Se64s/eurorack-clock-divider/README.md

# eurorack-clock-divider

Clock divider based on [Divide &amp; Conquer](https://www.nonlinearcircuits.com/modules/p/divide-and-conquer) from NONLINEARCIRCUITS.
