Se64s/eurorack-clock-divider/pcb/clock-divider-pcb.kicad_pcb

## KiCad design pcb/clock-divider-pcb.kicad_pcb (2025-10-06)

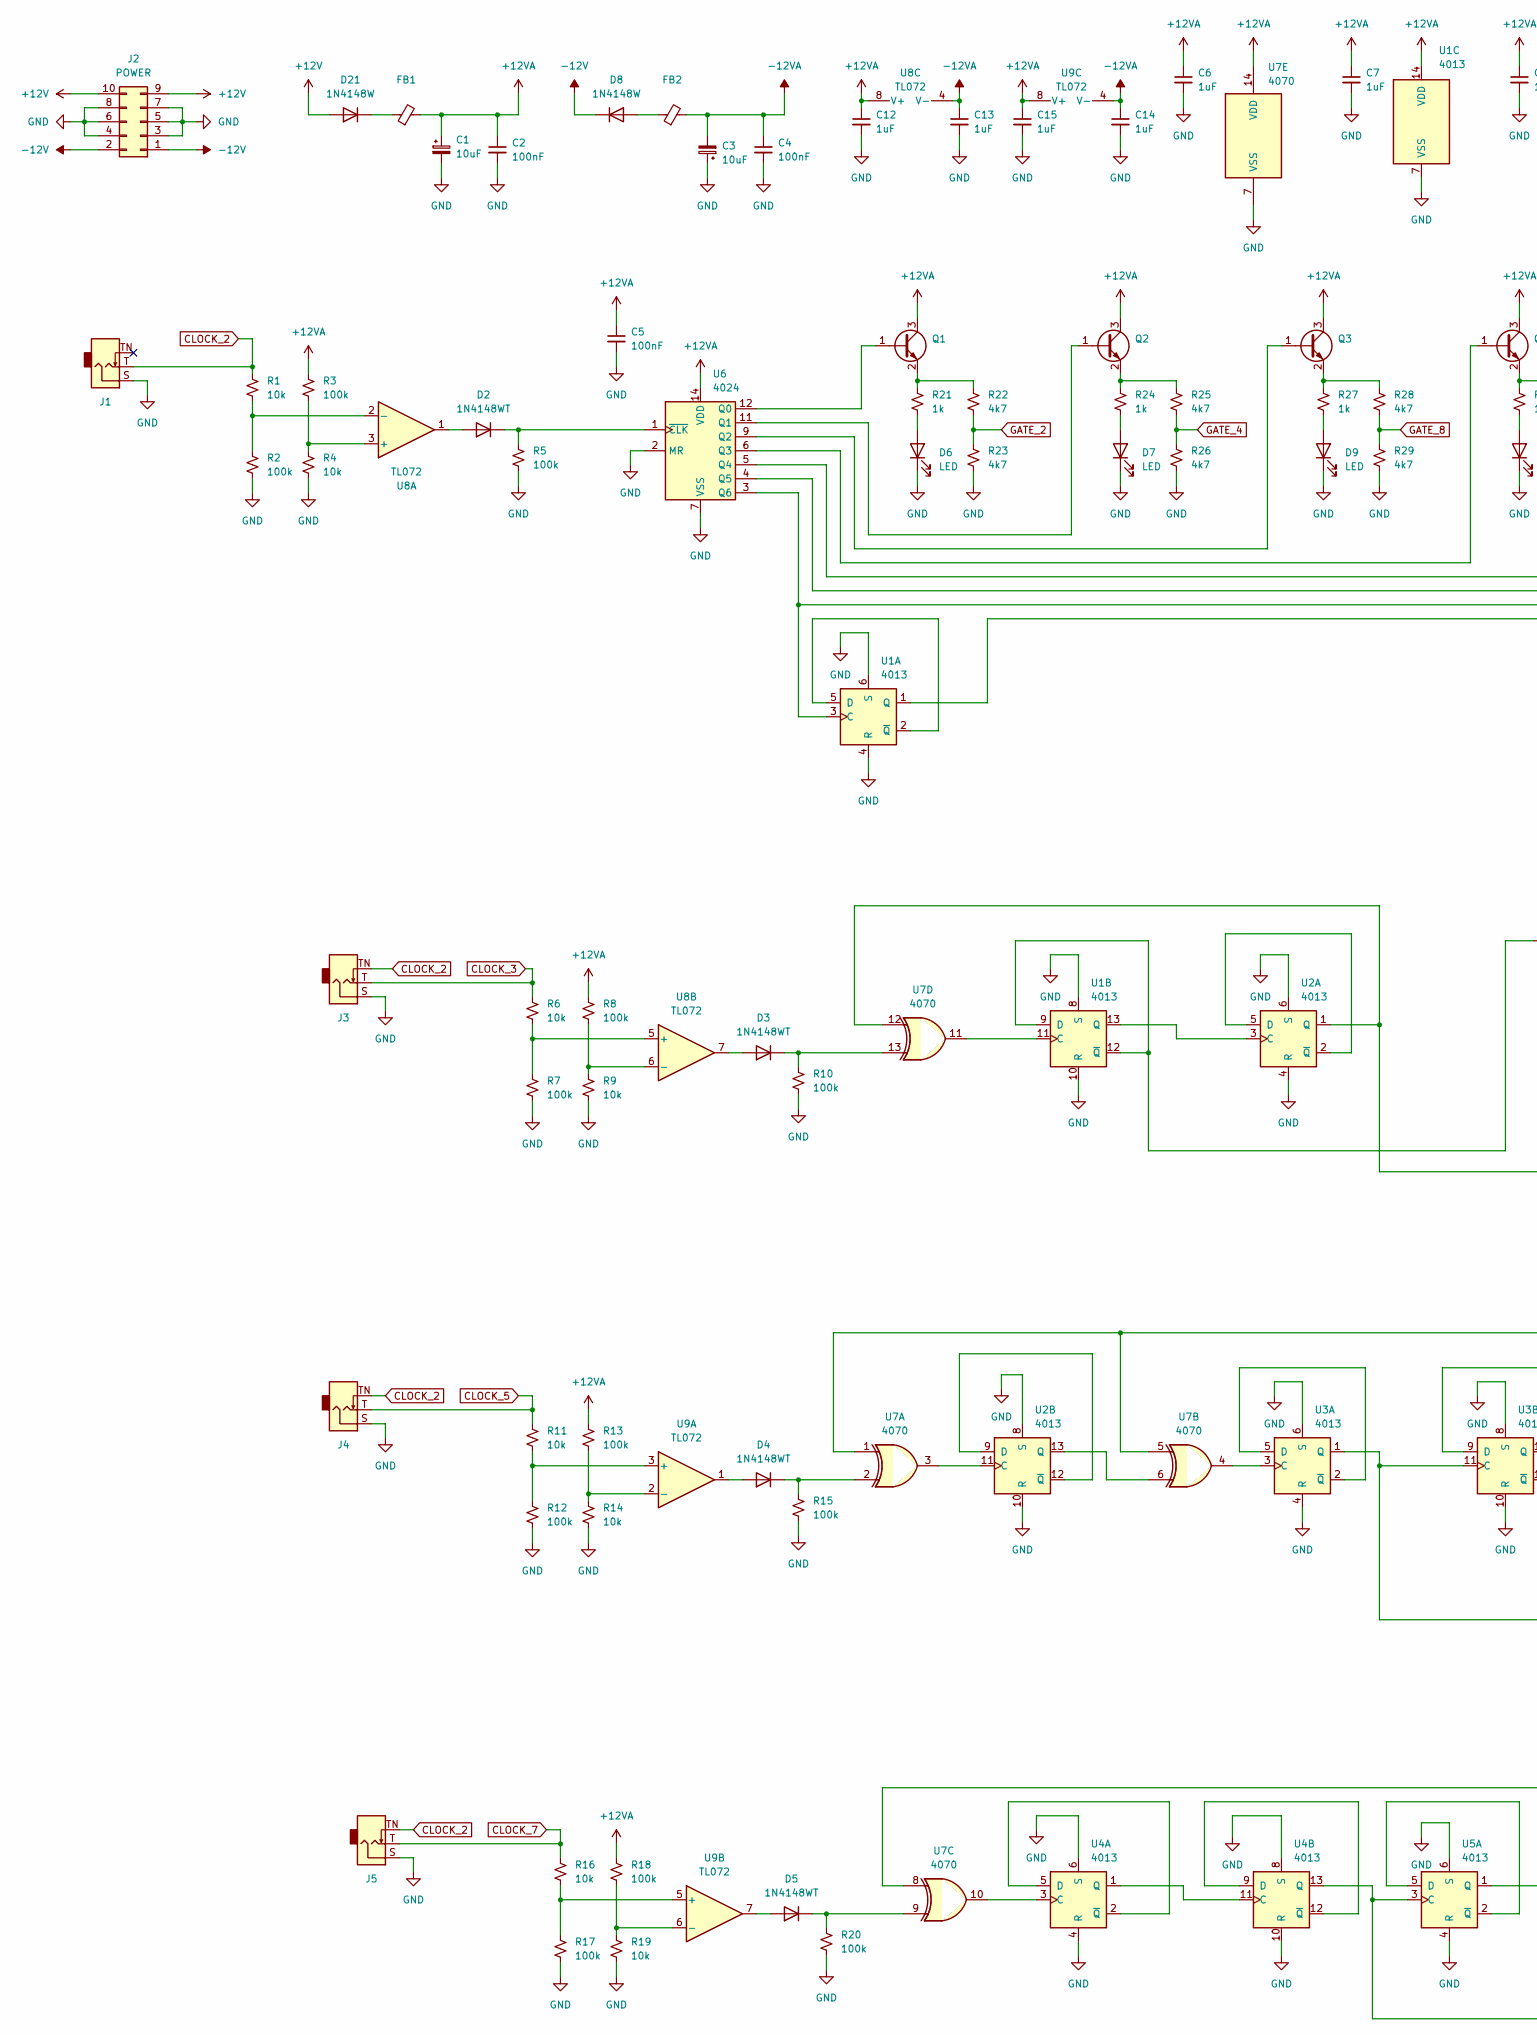
[picture p6: schematic clock-divider-pcb.kicad_sch, part in row 1, column 1]

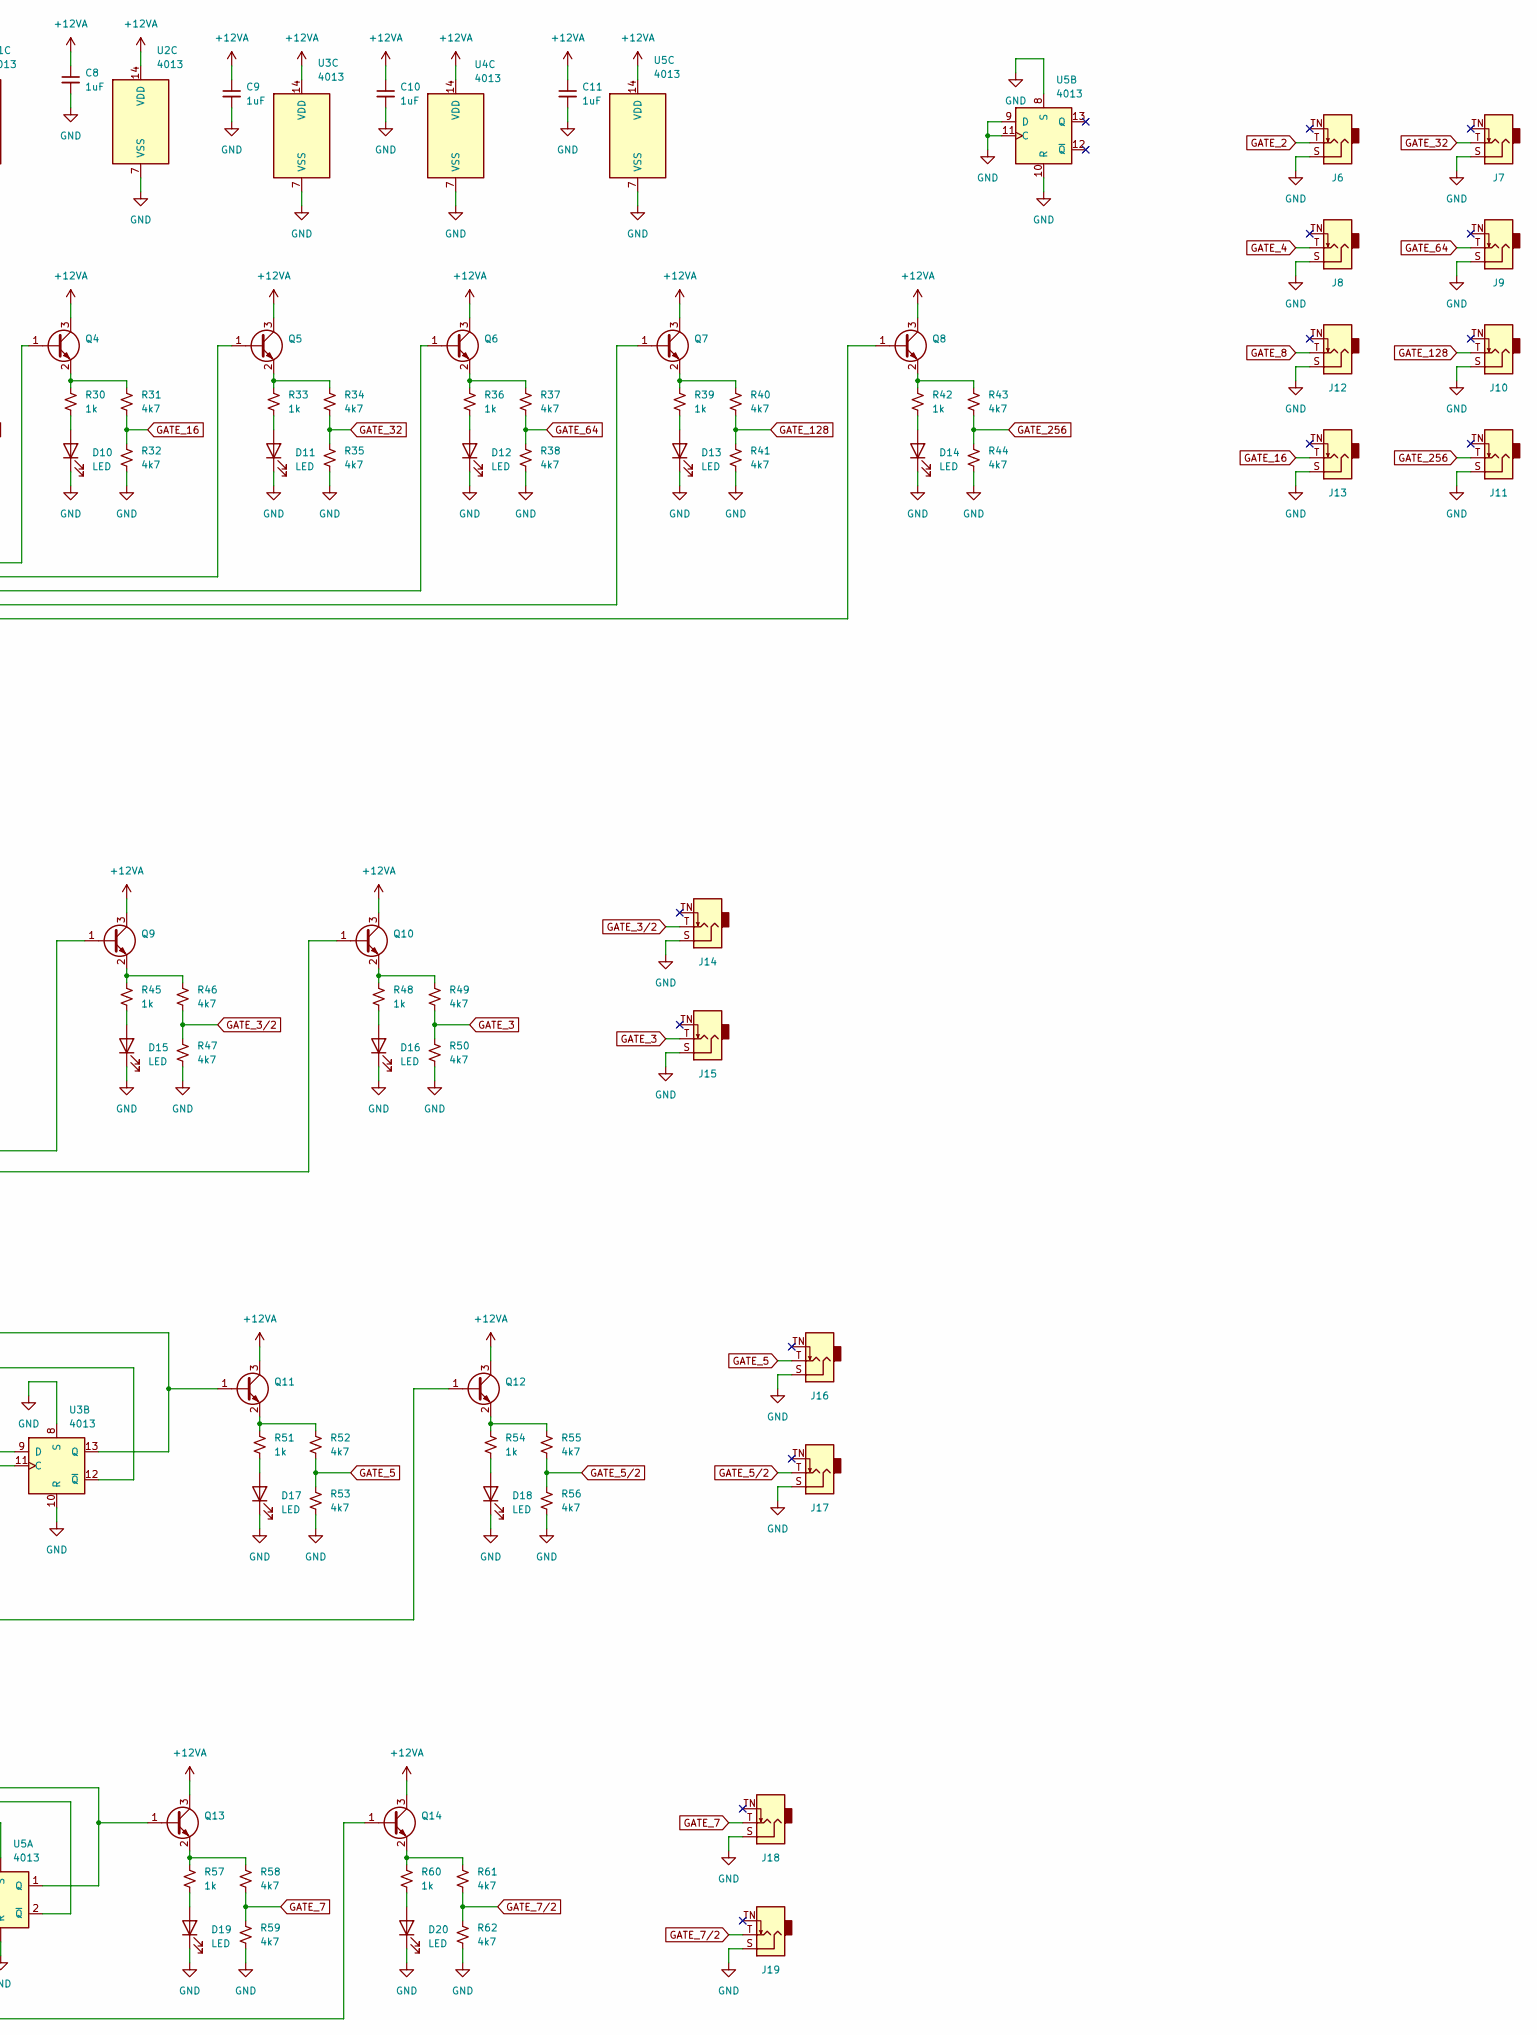
[picture p7: schematic clock-divider-pcb.kicad_sch, part in row 1, column 2]

Parts:
C1, C3: 10uF; CP_Elec_4x5.4
C2, C4, C5: 100nF; C_0805_2012Metric_Pad1.18x1.45mm_HandSolder
C6, C7, C8, C9, C10, C11, C12, C13, C14, C15: 1uF; C_0805_2012Metric_Pad1.18x1.45mm_HandSolder
D2, D3, D4, D5: 1N4148WT; D_SOD-523
D6, D7, D9, D10, D11, D12, D13, D14, D15, D16, D17, D18, D19, D20: LED; LED_0402_1005Metric_Pad0.77x0.64mm_HandSolder
D8, D21: 1N4148W; D_SOD-123
FB1, FB2: FerriteBead_Small; L_0805_2012Metric_Pad1.05x1.20mm_HandSolder
J1, J3, J4, J5, J6, J7, J8, J9, J10, J11, J12, J13, J14, J15, J16, J17, J18, J19: AudioJack2_SwitchT; Jack_3.5mm_QingPu_WQP-PJ398SM_Vertical_CircularHoles
J2: POWER; IDC-Header_2x05_P2.54mm_Vertical
Q1, Q2, Q3, Q4, Q5, Q6, Q7, Q8, Q9, Q10, Q11, Q12, Q13, Q14: MMBT3904; SOT-23
R1, R4, R6, R9, R11, R14, R16, R19: 10k; R_0603_1608Metric_Pad0.98x0.95mm_HandSolder
R2, R3, R5, R7, R8, R10, R12, R13, R15, R17, R18, R20: 100k; R_0603_1608Metric_Pad0.98x0.95mm_HandSolder
R21, R24, R27, R30, R33, R36, R39, R42, R45, R48, R51, R54, R57, R60: 1k; R_0603_1608Metric_Pad0.98x0.95mm_HandSolder
R22, R23, R25, R26, R28, R29, R31, R32, R34, R35, R37, R38, R40, R41, R43, R44, R46, R47, R49, R50, R52, R53, R55, R56, R58, R59, R61, R62: 4k7; R_0603_1608Metric_Pad0.98x0.95mm_HandSolder
U1, U2, U3, U4, U5: 4013; SOIC-14_3.9x8.7mm_P1.27mm
U6: 4024; SOIC-14_3.9x8.7mm_P1.27mm
U7: 4070; SOIC-14_3.9x8.7mm_P1.27mm
U8, U9: TL072; SOIC-8_3.9x4.9mm_P1.27mm

Connections:
+12V: D21.2 (A), J2.9, J2.10
+12VA: C1.1, C2.1, C5.1, C6.1, C7.1, C8.1, C9.1, C10.1, C11.1, C12.1, C15.1, FB1.2, Q1.3 (C), Q2.3 (C), Q3.3 (C), Q4.3 (C), Q5.3 (C), Q6.3 (C), Q7.3 (C), Q8.3 (C), Q9.3 (C), Q10.3 (C), Q11.3 (C), Q12.3 (C), Q13.3 (C), Q14.3 (C), R3.1, R8.1, R13.1, R18.1, U1.14 (VDD), U2.14 (VDD), U3.14 (VDD), U4.14 (VDD), U5.14 (VDD), U6.14 (VDD), U7.14 (VDD), U8.8 (V+), U9.8 (V+)
-12V: D8.1 (K), J2.1, J2.2
-12VA: C3.2, C4.1, C13.1, C14.1, FB2.2, U8.4 (V-), U9.4 (V-)
CLOCK_2: J1.T, J3.TN, J4.TN, J5.TN, R1.1
CLOCK_3: J3.T, R6.1
CLOCK_5: J4.T, R11.1
CLOCK_7: J5.T, R16.1
GATE_2: J6.T, R22.2, R23.1
GATE_3: J15.T, R49.2, R50.1
GATE_3/2: J14.T, R46.2, R47.1
GATE_4: J8.T, R25.2, R26.1
GATE_5: J16.T, R52.2, R53.1
GATE_5/2: J17.T, R55.2, R56.1
GATE_7: J18.T, R58.2, R59.1
GATE_7/2: J19.T, R61.2, R62.1
GATE_8: J12.T, R28.2, R29.1
GATE_16: J13.T, R31.2, R32.1
GATE_32: J7.T, R34.2, R35.1
GATE_64: J9.T, R37.2, R38.1
GATE_128: J10.T, R40.2, R41.1
GATE_256: J11.T, R43.2, R44.1
GND: C1.2, C2.2, C3.1, C4.2, C5.2, C6.2, C7.2, C8.2, C9.2, C10.2, C11.2, C12.2, C13.2, C14.2, C15.2, D6.1 (K), D7.1 (K), D9.1 (K), D10.1 (K), D11.1 (K), D12.1 (K), D13.1 (K), D14.1 (K), D15.1 (K), D16.1 (K), D17.1 (K), D18.1 (K), D19.1 (K), D20.1 (K), J1.S, J2.3, J2.4, J2.5, J2.6, J2.7, J2.8, J3.S, J4.S, J5.S, J6.S, J7.S, J8.S, J9.S, J10.S, J11.S, J12.S, J13.S, J14.S, J15.S, J16.S, J17.S, J18.S, J19.S, R2.2, R4.2, R5.2, R7.2, R9.2, R10.2, R12.2, R14.2, R15.2, R17.2, R19.2, R20.2, R23.2, R26.2, R29.2, R32.2, R35.2, R38.2, R41.2, R44.2, R47.2, R50.2, R53.2, R56.2, R59.2, R62.2, U1.4 (R), U1.6 (S), U1.7 (VSS), U1.8 (S), U1.10 (R), U2.4 (R), U2.6 (S), U2.7 (VSS), U2.8 (S), U2.10 (R), U3.4 (R), U3.6 (S), U3.7 (VSS), U3.8 (S), U3.10 (R), U4.4 (R), U4.6 (S), U4.7 (VSS), U4.8 (S), U4.10 (R), U5.4 (R), U5.6 (S), U5.7 (VSS), U5.8 (S), U5.9 (D), U5.10 (R), U5.11 (C), U6.2 (MR), U6.7 (VSS), U7.7 (VSS)
unnamed: D2.2 (A), U8.1
unnamed: D2.1 (K), R5.1, U6.1 (~CLK)
unnamed: D3.2 (A), U8.7
unnamed: D3.1 (K), R10.1, U7.13
unnamed: D4.2 (A), U9.1
unnamed: D4.1 (K), R15.1, U7.2
unnamed: D5.2 (A), U9.7
unnamed: D5.1 (K), R20.1, U7.9
unnamed: D6.2 (A), R21.2
unnamed: D7.2 (A), R24.2
unnamed: D8.2 (A), FB2.1
unnamed: D9.2 (A), R27.2
unnamed: D10.2 (A), R30.2
unnamed: D11.2 (A), R33.2
unnamed: D12.2 (A), R36.2
unnamed: D13.2 (A), R39.2
unnamed: D14.2 (A), R42.2
unnamed: D15.2 (A), R45.2
unnamed: D16.2 (A), R48.2
unnamed: D17.2 (A), R51.2
unnamed: D18.2 (A), R54.2
unnamed: D19.2 (A), R57.2
unnamed: D20.2 (A), R60.2
unnamed: D21.1 (K), FB1.1
unnamed: Q1.1 (B), U6.12 (Q0)
unnamed: Q1.2 (E), R21.1, R22.1
unnamed: Q2.1 (B), U6.11 (Q1)
unnamed: Q2.2 (E), R24.1, R25.1
unnamed: Q3.1 (B), U6.9 (Q2)
unnamed: Q3.2 (E), R27.1, R28.1
unnamed: Q4.1 (B), U6.6 (Q3)
unnamed: Q4.2 (E), R30.1, R31.1
unnamed: Q5.1 (B), U6.5 (Q4)
unnamed: Q5.2 (E), R33.1, R34.1
unnamed: Q6.1 (B), U6.4 (Q5)
unnamed: Q6.2 (E), R36.1, R37.1
unnamed: Q7.1 (B), U1.3 (C), U6.3 (Q6)
unnamed: Q7.2 (E), R39.1, R40.1
unnamed: Q8.1 (B), U1.1 (Q)
unnamed: Q8.2 (E), R42.1, R43.1
unnamed: Q9.1 (B), U1.9 (D), U1.12 (~Q)
unnamed: Q9.2 (E), R45.1, R46.1
unnamed: Q10.1 (B), U2.1 (Q), U7.12
unnamed: Q10.2 (E), R48.1, R49.1
unnamed: Q11.1 (B), U3.13 (Q), U7.1, U7.5
unnamed: Q11.2 (E), R51.1, R52.1
unnamed: Q12.1 (B), U3.1 (Q), U3.11 (C)
unnamed: Q12.2 (E), R54.1, R55.1
unnamed: Q13.1 (B), U5.1 (Q), U7.8
unnamed: Q13.2 (E), R57.1, R58.1
unnamed: Q14.1 (B), U4.13 (Q), U5.3 (C)
unnamed: Q14.2 (E), R60.1, R61.1
unnamed: U1.2 (~Q), U1.5 (D)
unnamed: U1.11 (C), U7.11
unnamed: U1.13 (Q), U2.3 (C)
unnamed: U2.2 (~Q), U2.5 (D)
unnamed: U2.11 (C), U7.3
unnamed: U2.9 (D), U2.12 (~Q)
unnamed: U2.13 (Q), U7.6
unnamed: U3.3 (C), U7.4
unnamed: U3.2 (~Q), U3.5 (D)
unnamed: U3.9 (D), U3.12 (~Q)
unnamed: U4.3 (C), U7.10
unnamed: U4.2 (~Q), U4.5 (D)
unnamed: U4.1 (Q), U4.11 (C)
unnamed: U4.9 (D), U4.12 (~Q)
unnamed: U5.2 (~Q), U5.5 (D)
unnamed: R3.2, R4.1, U8.3 (+)
unnamed: R1.2, R2.1, U8.2 (-)
unnamed: R6.2, R7.1, U8.5 (+)
unnamed: R8.2, R9.1, U8.6 (-)
unnamed: R11.2, R12.1, U9.3 (+)
unnamed: R13.2, R14.1, U9.2 (-)
unnamed: R16.2, R17.1, U9.5 (+)
unnamed: R18.2, R19.1, U9.6 (-)

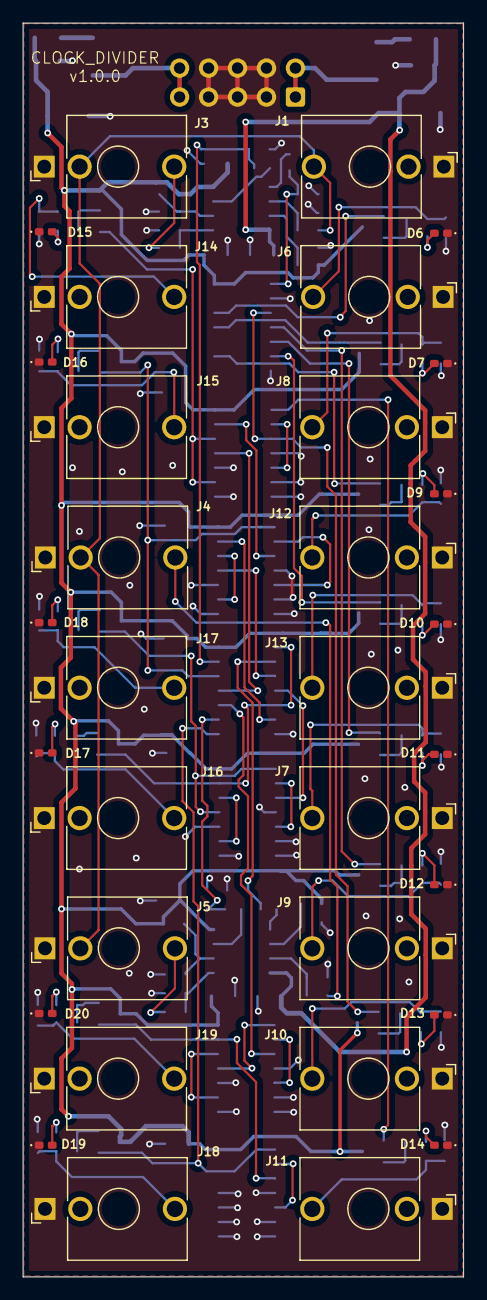
[picture p8: board clock-divider-pcb.kicad_pcb from above]

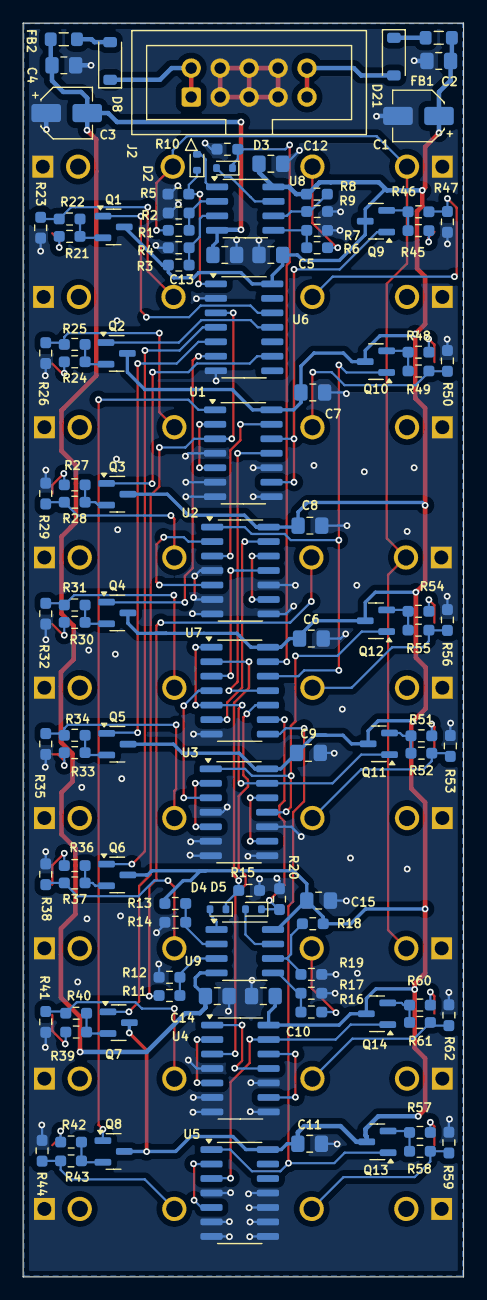
[picture p9: board clock-divider-pcb.kicad_pcb from below]

Board: 2 copper layers, 38.6 x 110.0 mm, 141 parts (109 on the bottom side), 98 nets.
